MarioGavran/smart_intercom/images/20210518_152732.jpg

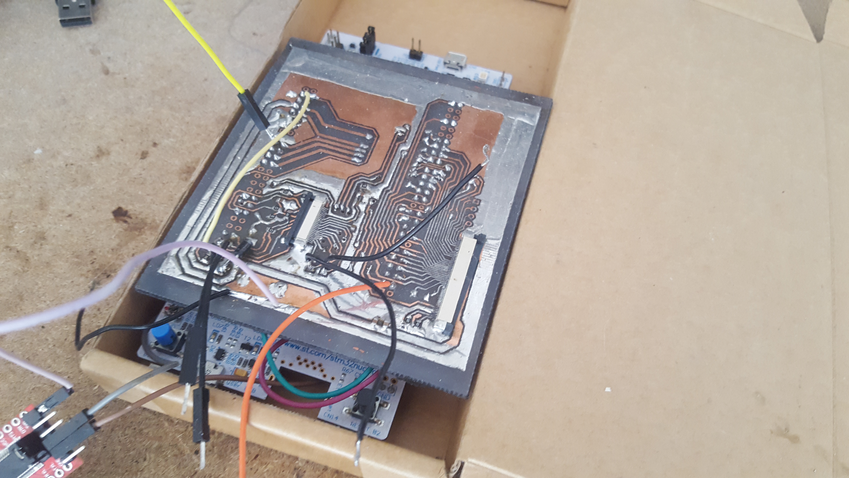
images/20210518_152732.jpg
