MarioGavran/smart_intercom/images/20210518_152829.jpg

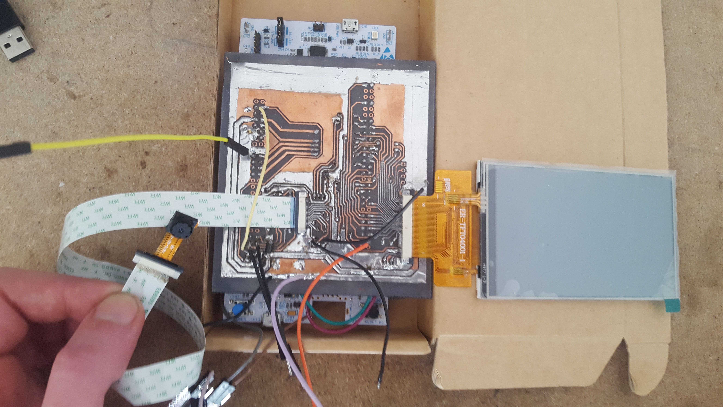
images/20210518_152829.jpg
