MarioGavran/smart_intercom/images/img1.jpg

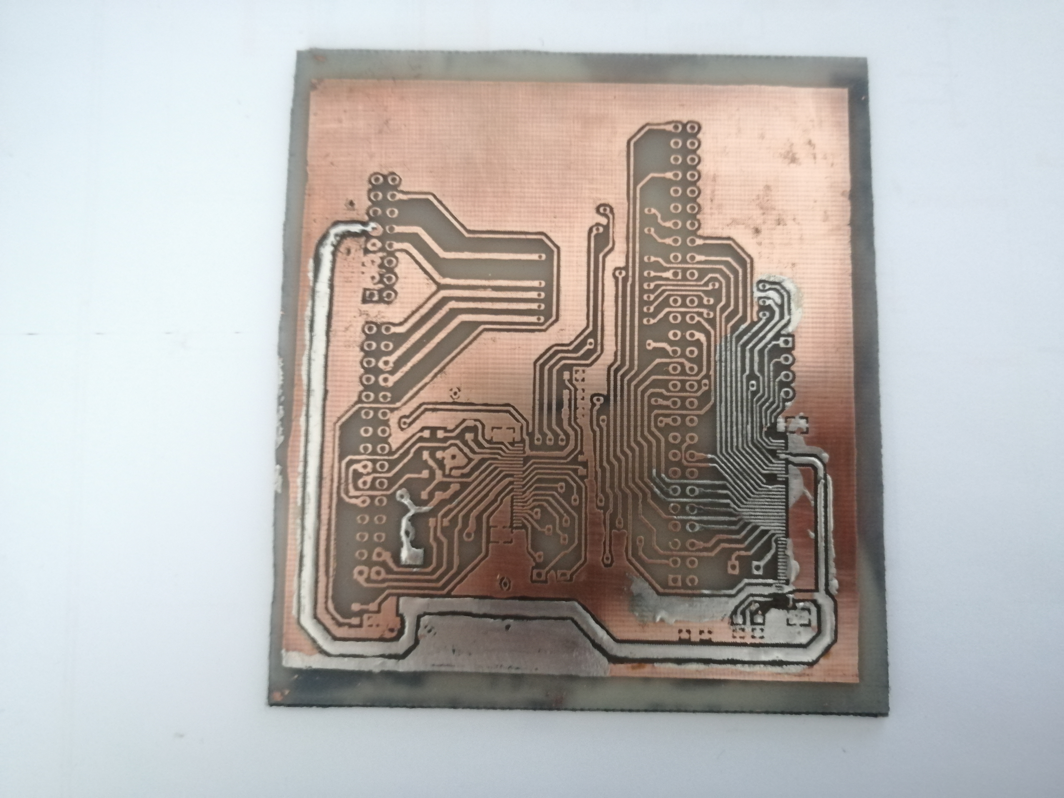
images/img1.jpg
