MarioGavran/smart_intercom/images/img3.jpg

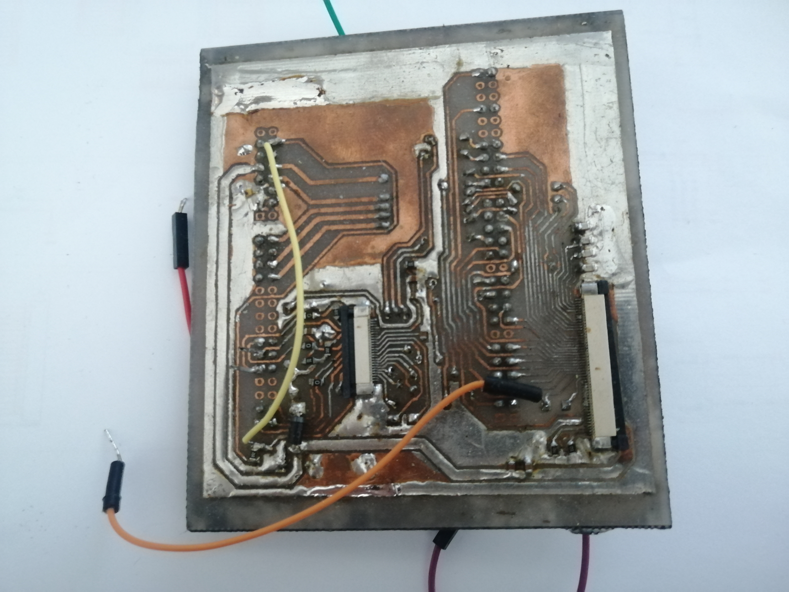
images/img3.jpg
