MarioGavran/smart_intercom/images/img4.jpg

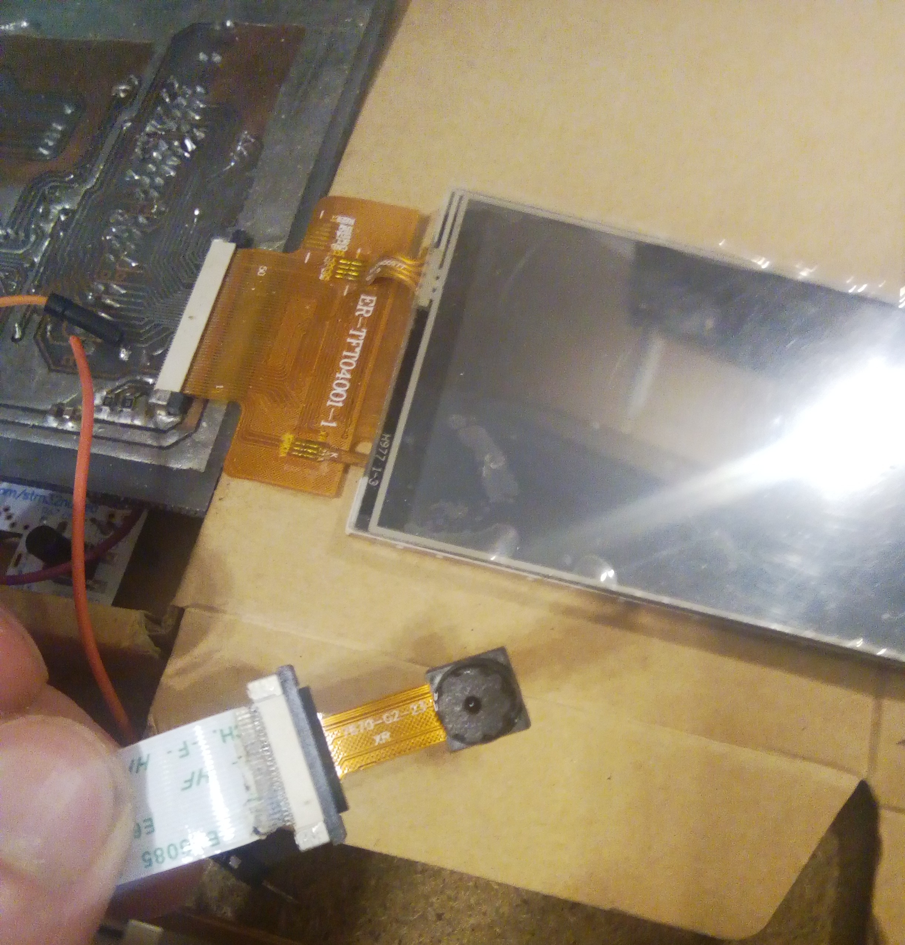
images/img4.jpg
