MarioGavran/smart_intercom/images/img5.jpg

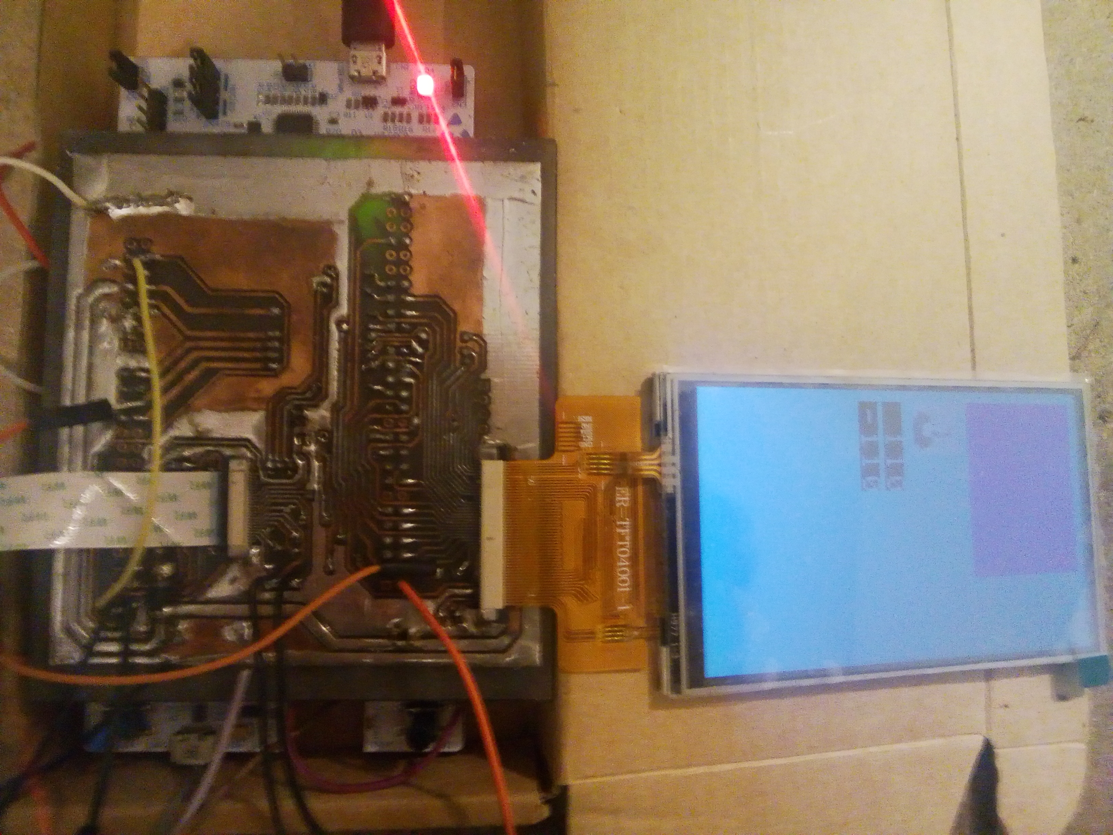
images/img5.jpg
