MarioGavran/smart_intercom/images/img7.jpg

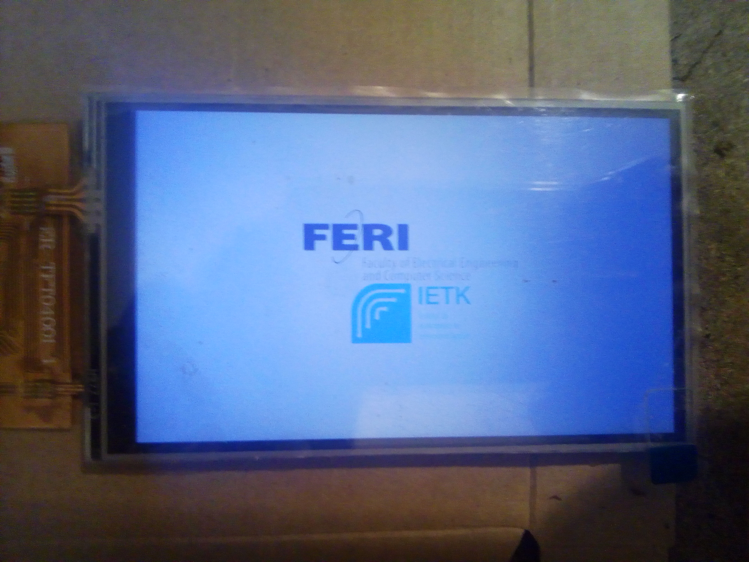
images/img7.jpg
