MarioGavran/smart_intercom/images/img8.jpg

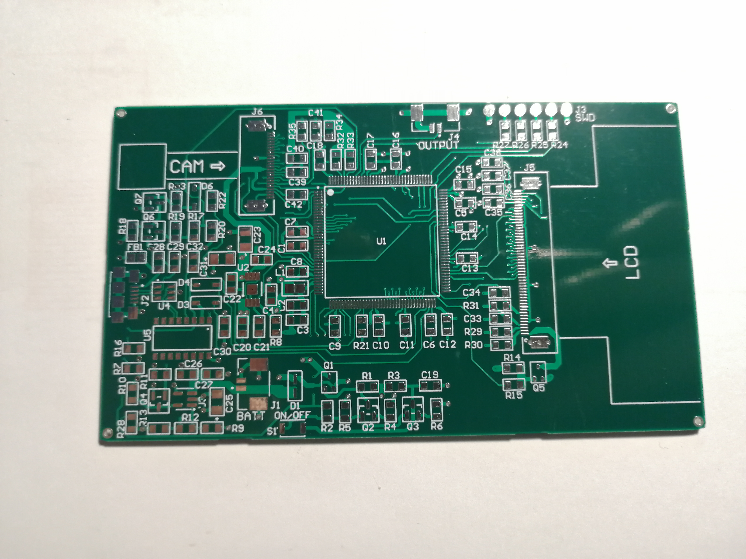
images/img8.jpg
