MarioGavran/smart_intercom/images/img9.jpg

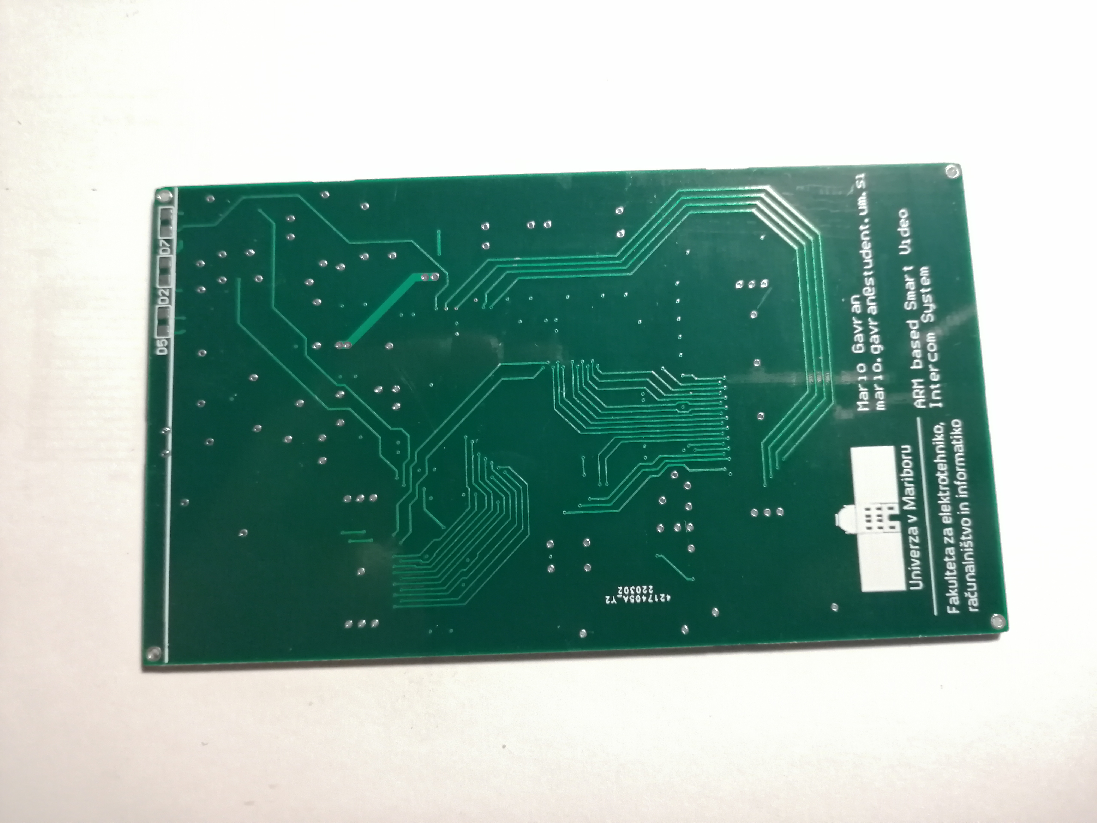
images/img9.jpg
