MarioGavran/smart_intercom/images/img11.jpg

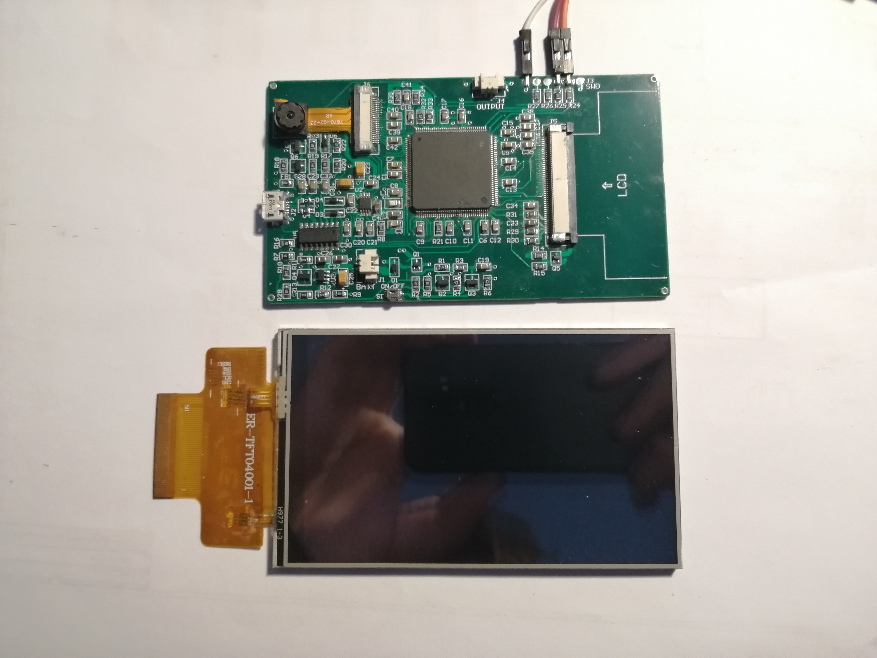
images/img11.jpg
