MarioGavran/smart_intercom/images/img12.jpg

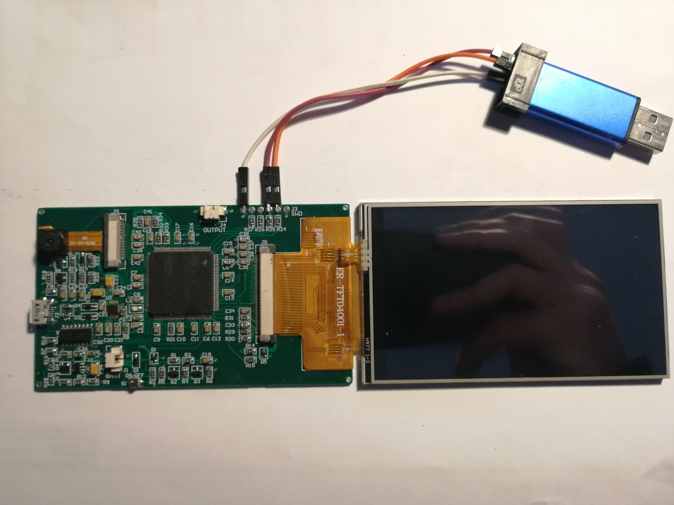
images/img12.jpg
