MarioGavran/smart_intercom/Doc/Schematics.pdf

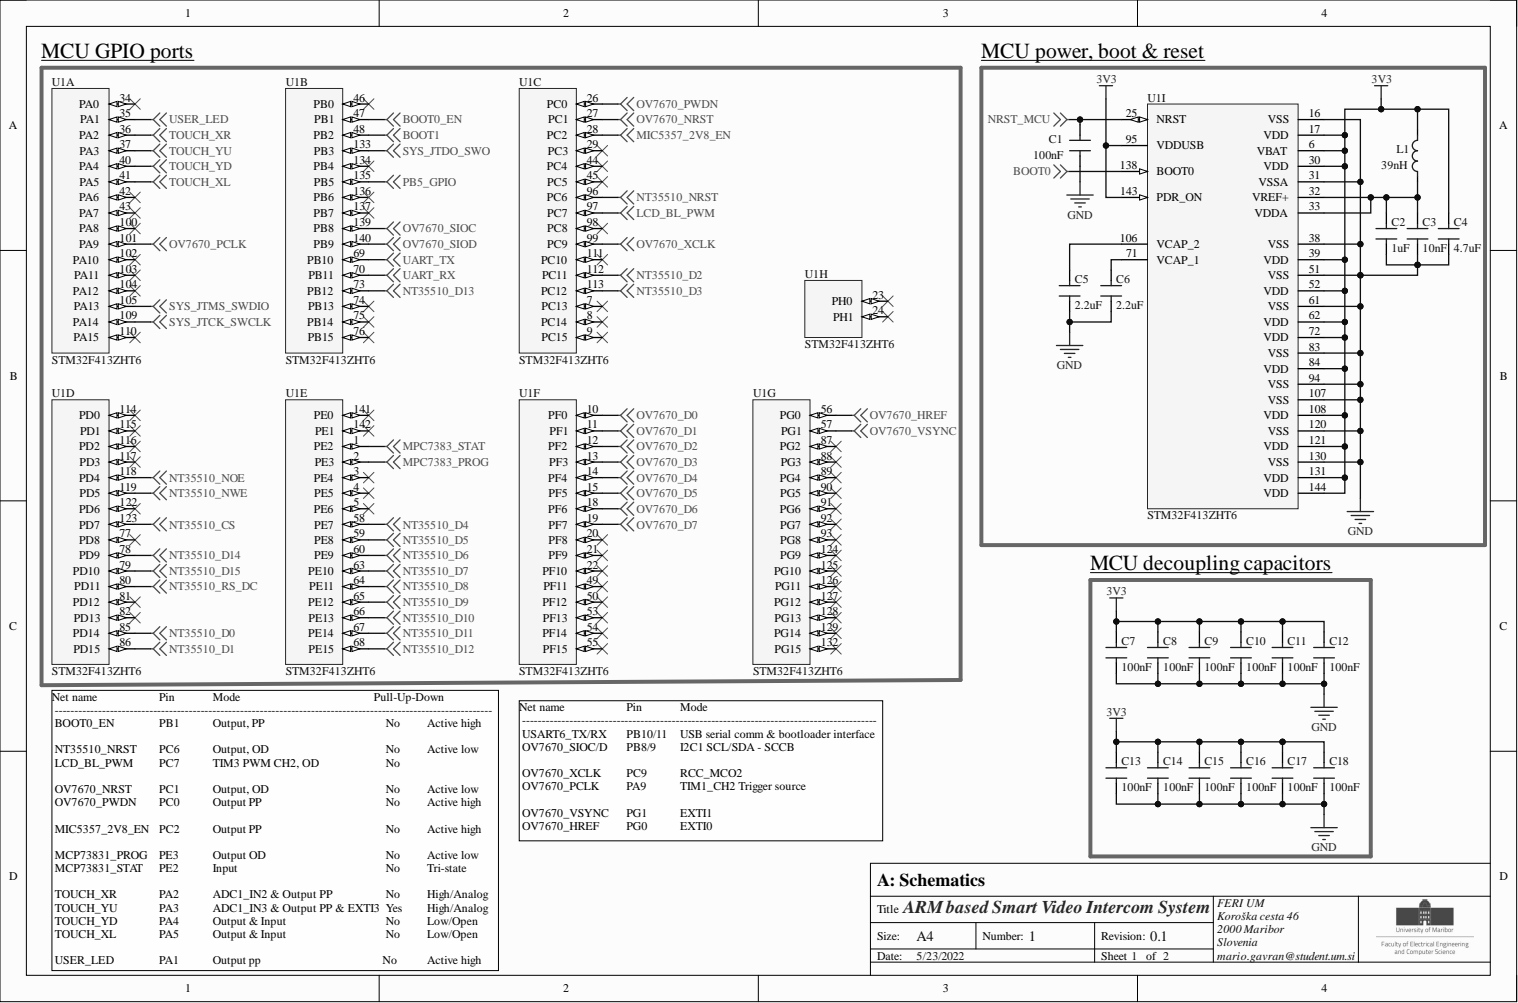
[picture p23: page 1]
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

Size: A | N u mber: | Rev i s i o n : .
Date: / / | | Shee t o f

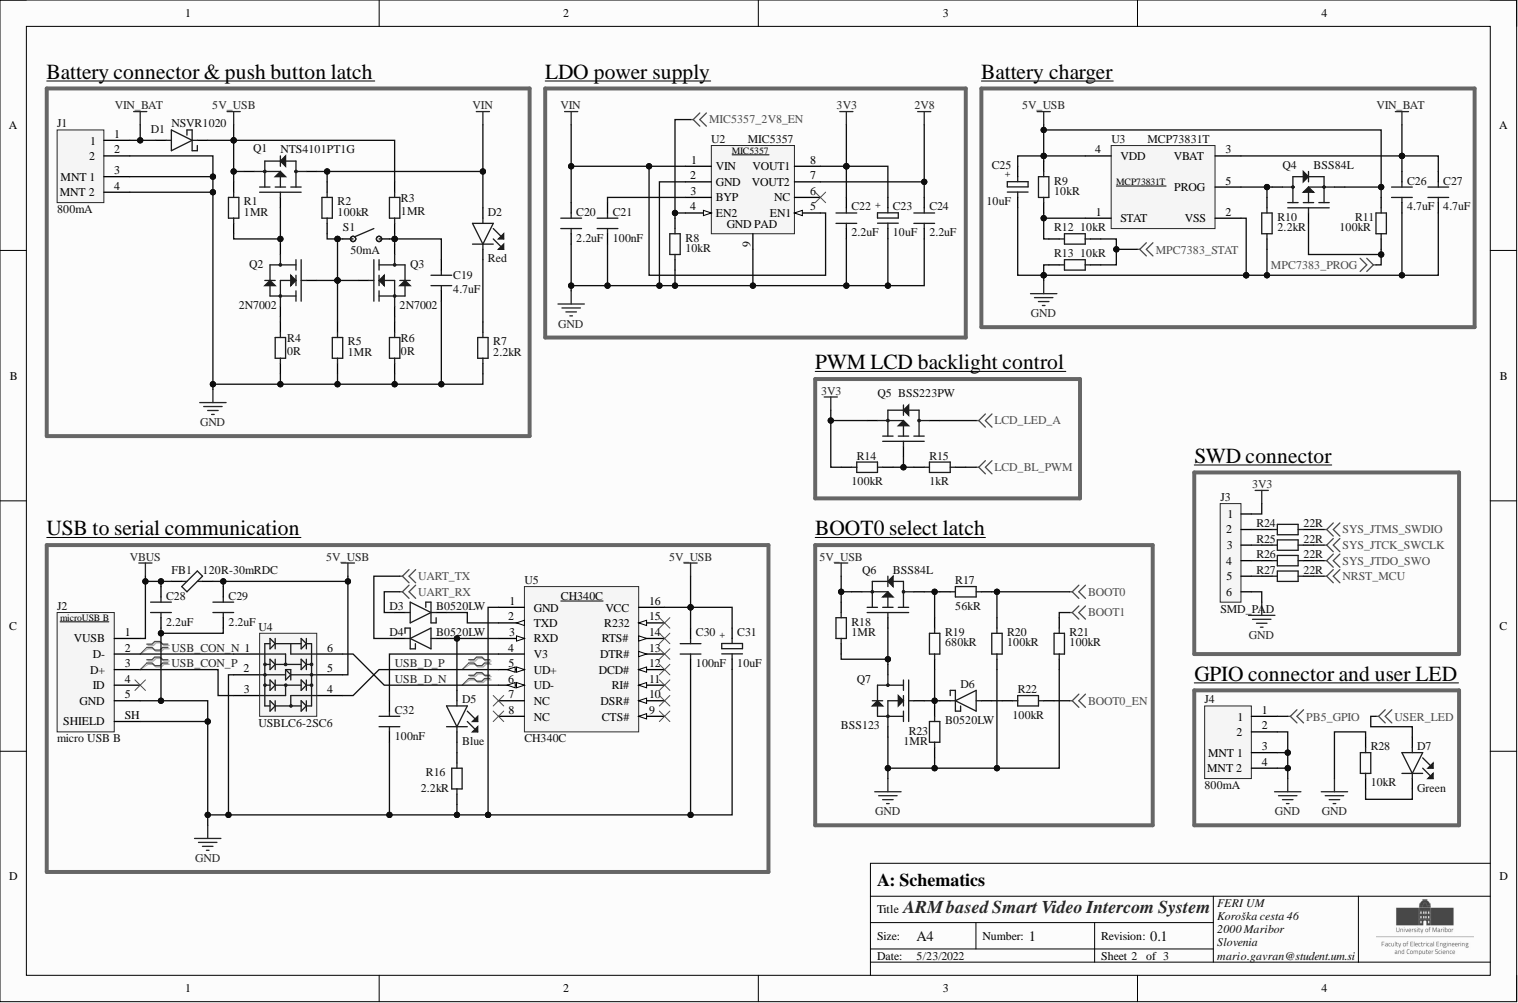
[picture p24: page 2]

EN2 4 EN1 GND 2 GND PAD | 5 NC 6 VOUT2 7 VOUT1 8 MIC5357

BYP 3

STAT 1

PWM LCD backlight control

GND
GPIO connector and user LED

A: Schematics
ARM based Smart Video Intercom System
Title

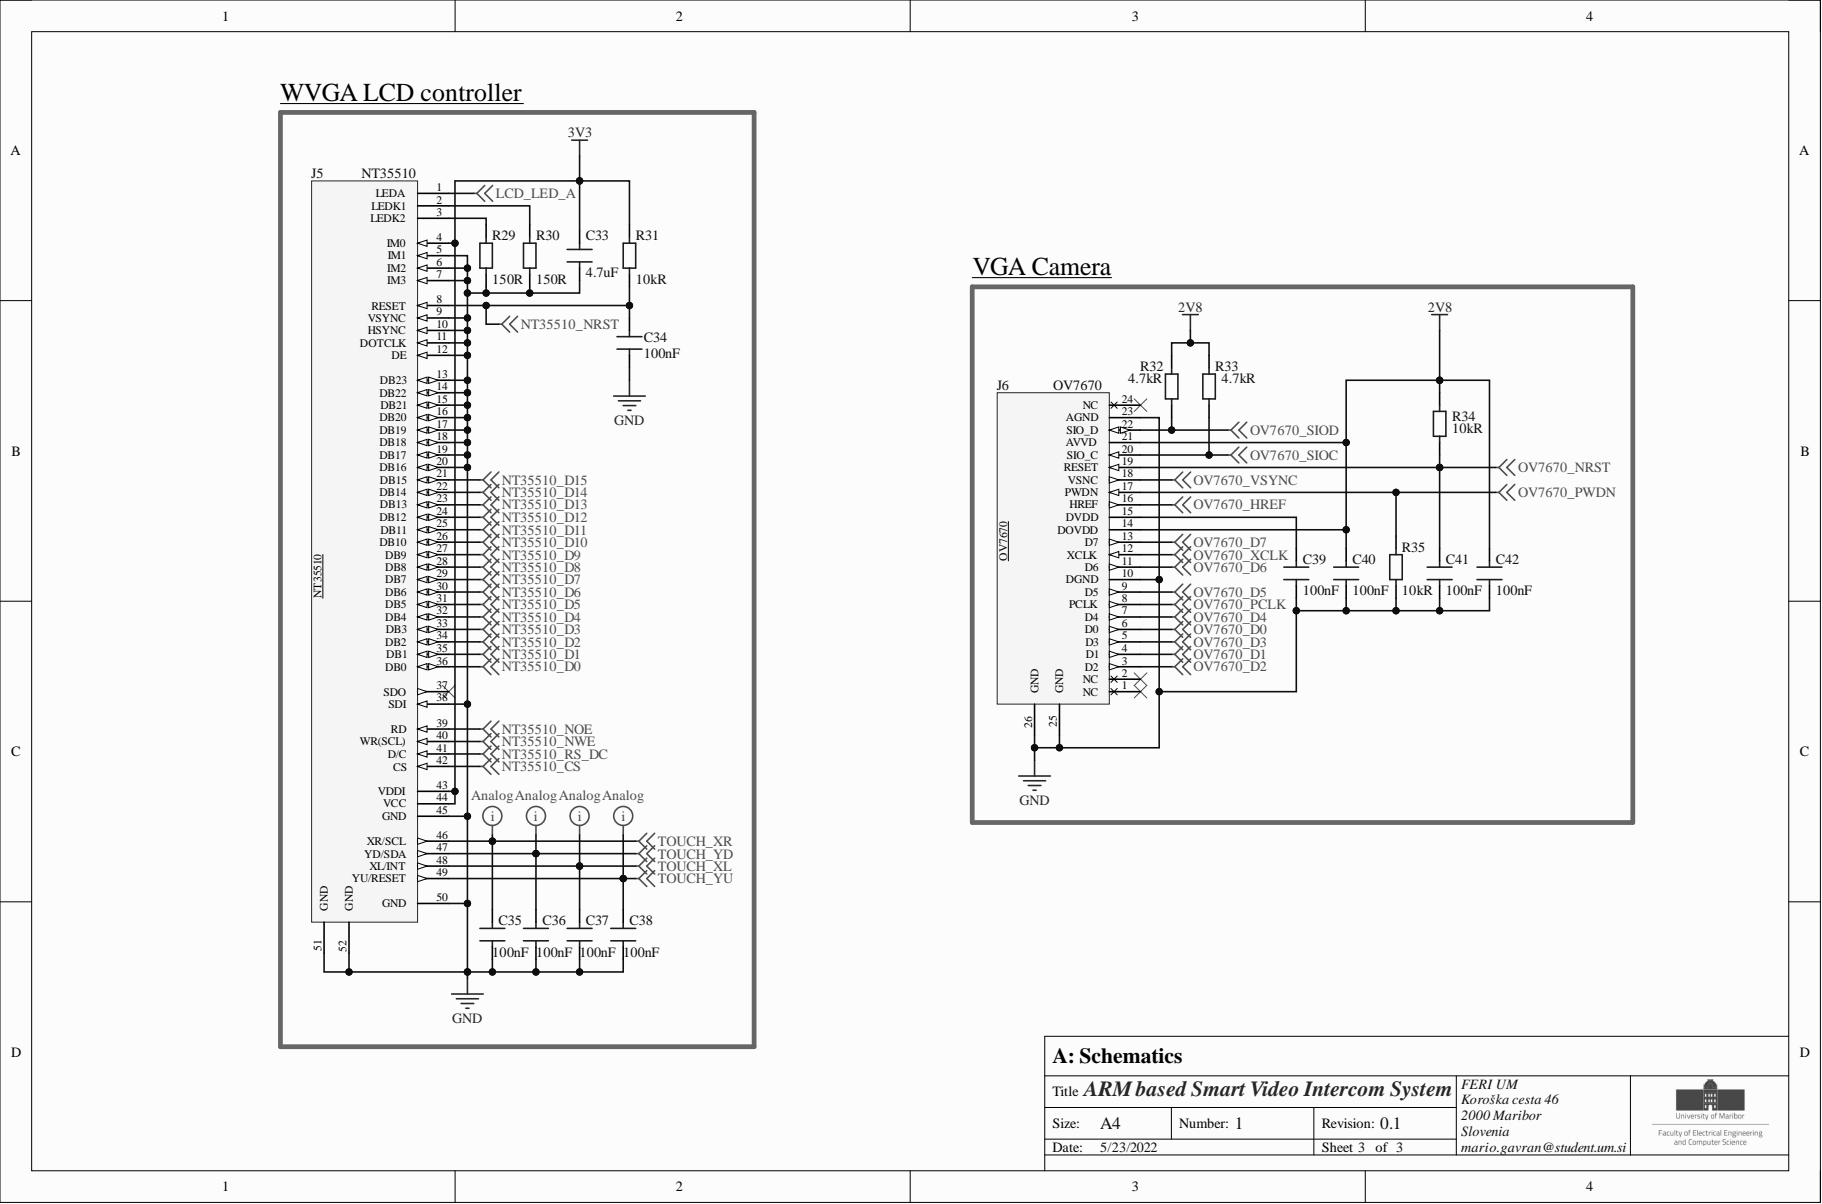
[picture p25: page 3]

O V 7 6 7 0 _ VSY N C
O V 7 6 7 0 _ HRE F

FERI UM Koroška ces
