MarioGavran/smart_intercom/Core/Src/uart_driver.c

/*
 * uart_driver.c
 *
 *  Created on: Mar 18, 2021
 *      Author: Mario
 */
#include "uart_driver.h"


uart_tx_state_t g_uart_tx_state = UART_TX_IDLE;
uart_rx_state_t g_uart_rx_state = UART_RX_IDLE;

uint8_t g_uart_tx_buffer[UART_TX_BUFFER_MAX + 1] = {0};
uint16_t g_uart_tx_nose = 0;
uint16_t g_uart_tx_tail = 0;

uint8_t g_uart_rx_buffer[UART_RX_BUFFER_MAX + 1];
uint8_t g_uart_rx_tmp_buf[50];
uint16_t g_uart_rx_nose = 0;
uint16_t g_uart_rx_tail = 0;
uint16_t g_uart_rx_cnt = 0;



//~=~=~=~=~=~=~=~=~=~=~=~=~=~=~=~=~=~=~=~=~=~=~=~=~=~=~=~=~=~=~=~=~=~=~=~=~=~=~=~=~=~=~=~=~=~=
void uart_init()
{
	__HAL_UART_ENABLE_IT(&huart3, UART_IT_RXNE);
}



//~=~=~=~=~=~=~=~=~=~=~=~=~=~=~=~=~=~=~=~=~=~=~=~=~=~=~=~=~=~=~=~=~=~=~=~=~=~=~=~=~=~=~=~=~=~=
void uart_tx_process()
{
	static uint8_t last_nose = 0;
	uint8_t string_size;

	switch(g_uart_tx_state)
	{
	//****************************
	case UART_TX_IDLE:
		if(g_uart_tx_nose != g_uart_tx_tail)
			g_uart_tx_state = UART_TX_TRANSMIT;
		break;

		//****************************
	case UART_TX_TRANSMIT:
		string_size = strlen(g_uart_tx_buffer + (g_uart_tx_nose)) + 1;

		HAL_UART_Transmit_IT(
				&huart3,
				g_uart_tx_buffer + g_uart_tx_nose,
				string_size);

		last_nose = g_uart_tx_nose;
		g_uart_tx_state = UART_TX_TRANSMITING;
		break;

		//****************************
	case UART_TX_TRANSMITING:
		if((last_nose == g_uart_tx_nose))
			g_uart_tx_state = UART_TX_TRANSMITING;
		else if((last_nose != g_uart_tx_nose) && (g_uart_tx_tail != g_uart_tx_nose))
			g_uart_tx_state = UART_TX_TRANSMIT;
		else if((last_nose != g_uart_tx_nose) && (g_uart_tx_tail == g_uart_tx_nose))
			g_uart_tx_state = UART_TX_IDLE;
		break;
	}
}



//~=~=~=~=~=~=~=~=~=~=~=~=~=~=~=~=~=~=~=~=~=~=~=~=~=~=~=~=~=~=~=~=~=~=~=~=~=~=~=~=~=~=~=~=~=~=
void uart_write(uint8_t* buff)
{
	uint8_t string_size = strlen(buff) + 1;

	if(
			((g_uart_tx_tail - g_uart_tx_nose >= 0) && (string_size < UART_TX_BUFFER_MAX - (g_uart_tx_tail - g_uart_tx_nose))) ||
			((g_uart_tx_tail - g_uart_tx_nose <= 0) && (string_size < g_uart_tx_nose - g_uart_tx_tail)))
	{
		if(((g_uart_tx_tail - g_uart_tx_nose >= 0)) && (string_size > (UART_TX_BUFFER_MAX - g_uart_tx_tail)))
		{
			strncpy(g_uart_tx_buffer + g_uart_tx_tail, buff, UART_TX_BUFFER_MAX - g_uart_tx_tail);
			string_size -= (UART_TX_BUFFER_MAX - g_uart_tx_tail);
			strncpy(g_uart_tx_buffer + 0, buff + (UART_TX_BUFFER_MAX - g_uart_tx_tail), string_size);
			g_uart_tx_tail = 0;
			g_uart_tx_tail = string_size;
		}
		else
		{
			strcpy(g_uart_tx_buffer + g_uart_tx_tail, buff);
			if(g_uart_tx_tail + string_size < UART_TX_BUFFER_MAX)
				g_uart_tx_tail += string_size;
			else
				g_uart_tx_tail = 0;
		}
	}
}



//~=~=~=~=~=~=~=~=~=~=~=~=~=~=~=~=~=~=~=~=~=~=~=~=~=~=~=~=~=~=~=~=~=~=~=~=~=~=~=~=~=~=~=~=~=~=
void HAL_UART_TxCpltCallback(UART_HandleTypeDef *huart)
{
	g_uart_tx_nose += strlen(g_uart_tx_buffer + g_uart_tx_nose) + 1;

	if(g_uart_tx_nose >= UART_TX_BUFFER_MAX)
		g_uart_tx_nose = 0;

}



//~=~=~=~=~=~=~=~=~=~=~=~=~=~=~=~=~=~=~=~=~=~=~=~=~=~=~=~=~=~=~=~=~=~=~=~=~=~=~=~=~=~=~=~=~=~=
void uart_rx_process()
{
	uint8_t string_size = strlen(g_uart_rx_buffer + g_uart_rx_nose + 1) + 1;

	switch(g_uart_rx_state)
	{
	case UART_RX_IDLE:
		if(g_uart_rx_cnt)
			g_uart_rx_state = UART_RX_RECEIVE;
		break;

	case UART_RX_RECEIVE:
		if(g_uart_rx_nose < g_uart_rx_tail &&
				(g_uart_rx_buffer[g_uart_rx_nose + string_size - 2] == '\r') &&
				(g_uart_rx_buffer[g_uart_rx_nose + string_size - 1] == '\n'))
		{
			serial_protocol(g_uart_rx_buffer + g_uart_rx_nose + 1);
		}
		else if((g_uart_rx_nose > g_uart_rx_tail) &&
							(g_uart_rx_buffer[strlen(g_uart_rx_buffer) - 1] == '\n'))
		{
			strncpy(g_uart_rx_tmp_buf, g_uart_rx_buffer + g_uart_rx_nose + 1, string_size);
			string_size = strlen(g_uart_rx_buffer + 1) + 1;
			strncpy(g_uart_rx_tmp_buf + strlen(g_uart_rx_tmp_buf), g_uart_rx_buffer , string_size);
			serial_protocol(g_uart_rx_tmp_buf);
		}

		g_uart_rx_cnt--;

		if(g_uart_rx_nose + string_size < UART_RX_BUFFER_MAX)
			g_uart_rx_nose += string_size;
		else
			g_uart_rx_nose = string_size;

		if(!g_uart_rx_cnt)
			g_uart_rx_state = UART_RX_IDLE;
		break;


	}
}



//~=~=~=~=~=~=~=~=~=~=~=~=~=~=~=~=~=~=~=~=~=~=~=~=~=~=~=~=~=~=~=~=~=~=~=~=~=~=~=~=~=~=~=~=~=~=
void uart_rx_callback()
{
	g_uart_rx_tail++;

	if((g_uart_rx_tail < (UART_RX_BUFFER_MAX - 1)) && ((g_uart_rx_nose < g_uart_rx_tail) || (g_uart_rx_nose - g_uart_rx_tail > 2/*1*/)))
	{
		g_uart_rx_buffer[g_uart_rx_tail] = (0x00FFU & USART3->DR);//253
		if((g_uart_rx_buffer[g_uart_rx_tail] == '\r') /*&& ((g_uart_rx_nose < g_uart_rx_tail) || (g_uart_rx_nose - g_uart_rx_tail > 2))*/)
		{
			g_uart_rx_buffer[++g_uart_rx_tail] = '\n';//254
			g_uart_rx_cnt++;
			g_uart_rx_buffer[++g_uart_rx_tail] = '\0';//255
			if((g_uart_rx_tail == UART_RX_BUFFER_MAX) && (g_uart_rx_nose > 0))
			{
				g_uart_rx_tail = 0;
			}
		}
	}
	else if((g_uart_rx_tail == (UART_RX_BUFFER_MAX - 1)) && (g_uart_rx_nose > 1)/*(g_uart_rx_nose < g_uart_rx_tail)*/)
	{
		g_uart_rx_buffer[g_uart_rx_tail] = (0x00FFU & USART3->DR);//254
		g_uart_rx_buffer[++g_uart_rx_tail] = '\0';//255
		if(g_uart_rx_buffer[g_uart_rx_tail - 1] == '\r')
		{
			g_uart_rx_cnt++;
			if(g_uart_rx_nose > 1)
			{
				g_uart_rx_tail = 0;
				g_uart_rx_buffer[g_uart_rx_tail] = '\n';//0
				g_uart_rx_buffer[++g_uart_rx_tail] = '\0';//1
			}
			else
			{
				//error - full
			}
		}
	}
	else if((g_uart_rx_tail == UART_RX_BUFFER_MAX) && (g_uart_rx_nose > 1))
	{
		g_uart_rx_buffer[g_uart_rx_tail] = '\0';
		g_uart_rx_tail = 1;
		g_uart_rx_buffer[g_uart_rx_tail] = (0x00FFU & USART3->DR);	//todo:zamjeni USART->DR za neki define

	}

}


#include <stdlib.h>
//~=~=~=~=~=~=~=~=~=~=~=~=~=~=~=~=~=~=~=~=~=~=~=~=~=~=~=~=~=~=~=~=~=~=~=~=~=~=~=~=~=~=~=~=~=~=
void serial_protocol(uint8_t* buff)
{
	char *token;
	char temp_buff[5] = {0};
	unsigned short address, value = 0xFF;
	unsigned short value1, value2, value3, value4 = 0xFF;

	token = strtok(buff, ",");

	if (strncmp(buff, "OVW", 3) == 0)
	{
		token = strtok(NULL, ",");
		strncpy(temp_buff, token, 2);
		address = strtoll(temp_buff, NULL, 16);

		token = strtok(NULL, ",");
		strncpy(temp_buff, token, 2);
		value = strtoll(temp_buff, NULL, 16);

		ov7670_write_register(address, value);
		sprintf(temp_buff, "%02X\0", address);
		LCD_PrintStr(20, 380, 0, 0x841FU, temp_buff, 5);
		sprintf(temp_buff, "%02X\0", ov7670_read_register(address));
		LCD_PrintStr(20, 420, 0, 0x841FU, temp_buff, 5);
	}
	else if (strncmp(buff, "OVR", 3) == 0)
	{
		token = strtok(NULL, ",");
		strncpy(temp_buff, token, 2);
		address = strtoll(temp_buff, NULL, 16);

		value = ov7670_read_register(address);

		sprintf(temp_buff, "%02X\0", address);
		LCD_PrintStr(20, 380, 0, 0x841FU, temp_buff, 5);
		sprintf(temp_buff, "%02X\0", value);
		LCD_PrintStr(20, 420, 0, 0x841FU, temp_buff, 5);
	}
	else if (strncmp(buff, "OVHV", 4) == 0)
	{
		token = strtok(NULL, ",");
		strncpy(temp_buff, token, 3);
		value1 = strtoll(temp_buff, NULL, 10);

		token = strtok(NULL, ",");
		strncpy(temp_buff, token, 3);
		value2 = strtoll(temp_buff, NULL, 10);

		token = strtok(NULL, ",");
		strncpy(temp_buff, token, 3);
		value3 = strtoll(temp_buff, NULL, 10);

		token = strtok(NULL, ",");
		strncpy(temp_buff, token, 3);
		value4 = strtoll(temp_buff, NULL, 10);

		ov7670_frame_control(value1, value2, value3, value4);
	}
	else if (strncmp(buff, "ROVHV", 5) == 0)
	{
		value = 0;
		value = ov7670_read_register(OV7670_HSTART) << 3;
		value |= ov7670_read_register(OV7670_HREF) & 0b00000111;
		sprintf(temp_buff, "%03d\0", value);
		LCD_PrintStr(100, 300, 0, 0x841FU, temp_buff, 5);

		value = 0;
		value = ov7670_read_register(OV7670_HSTOP) << 3;
		value |= (ov7670_read_register(OV7670_HREF) & 0b00111000) >> 3;
		sprintf(temp_buff, "%03d\0", value);
		LCD_PrintStr(100, 340, 0, 0x841FU, temp_buff, 5);

		value = 0;
		value = ov7670_read_register(OV7670_VSTART) << 2;
		value |= ov7670_read_register(OV7670_VREF) & 0b00000011;
		sprintf(temp_buff, "%03d\0", value);
		LCD_PrintStr(100, 380, 0, 0x841FU, temp_buff, 5);

		value = 0;
		value = ov7670_read_register(OV7670_VSTOP) << 2;
		value |= (ov7670_read_register(OV7670_VREF) & 0b00001100) >> 2;
		sprintf(temp_buff, "%03d\0", value);
		LCD_PrintStr(100, 420, 0, 0x841FU, temp_buff, 5);
	}
	else if (strncmp(buff, "SWI", 3) == 0)
	{
		token = strtok(NULL, ",");
		if (strncmp(token, "touch", 5) == 00)
			HAL_EXTI_GenerateSWI(&hexti_touch_YU);
	}
	else if(strncmp(buff, "OVSETF", 6) == 0)
	{
		token = strtok(NULL, ",");
		if(strncmp(token, "QVGA", 4) == 0)
		{
			g_ov7670_info.frame_params = ov7670_frame_params[FFMT_QVGA];
			ov7670_set_mode(300);
		}
		else if(strncmp(token, "QQVGA", 5) == 0)
		{
			g_ov7670_info.frame_params = ov7670_frame_params[FFMT_QQVGA];
			ov7670_set_mode(300);
		}
		else if(strncmp(token, "QQQVGA", 6) == 0)
		{
			g_ov7670_info.frame_params = ov7670_frame_params[FFMT_QQQVGA];
			ov7670_set_mode(300);
		}
		else if(strncmp(token, "CIF", 3) == 0)
		{
			g_ov7670_info.frame_params = ov7670_frame_params[FFMT_CIF];
			ov7670_set_mode(300);
		}
		else if(strncmp(token, "QCIF", 4) == 0)
		{
			g_ov7670_info.frame_params = ov7670_frame_params[FFMT_QCIF];
			ov7670_set_mode(300);
		}
	}
	else if(strncmp(buff, "OVSETC", 6) == 0)
	{
		token = strtok(NULL, ",");
		if(strncmp(token, "RGB5", 4) == 0)
			g_ov7670_info.color_fmt = CFMT_RGB555;
		else if(strncmp(token, "RGB6", 4) == 0)
			g_ov7670_info.color_fmt = CFMT_RGB565;
		else if(strncmp(token, "RGB4", 4) == 0)
			g_ov7670_info.color_fmt = CFMT_RGB444;
		else if(strncmp(token, "GRB", 3) == 0)
			g_ov7670_info.color_fmt = CFMT_GRB422;
		else if(strncmp(token, "YUV", 3) == 0)
			g_ov7670_info.color_fmt = CFMT_YUYV422;
		else if(strncmp(token, "RBAY", 4) == 0)
			g_ov7670_info.color_fmt = CFMT_RAW_BAYER;
		else if(strncmp(token, "PBAY", 4) == 0)
			g_ov7670_info.color_fmt = CFMT_PRO_BAYER;

		ov7670_set_mode(300);
	}
	else if(strncmp(buff, "OVSCL", 5) == 0)
	{
		token = strtok(NULL, ",");
		strncpy(temp_buff, token, 3);
		value1 = strtoll(temp_buff, NULL, 10);

		token = strtok(NULL, ",");
		strncpy(temp_buff, token, 3);
		value2 = strtoll(temp_buff, NULL, 10);

		ov7670_scaling_control(value1, value2);
	}
}
