MarioGavran/smart_intercom/Core/Src/feri_logo_image.c

#include <feri_logo_image.h>



const unsigned char g_feri_logo_image[FERI_LOGO_IMG_SIZE] = {
		0xff,0xff,0xff,0xff,0xff,0xff,0xff,0xff,0xff,0xff,0xff,0xff,0xff,0xff,0xff,0xff,0xff,0xff,0xff,0xff,0xff,0xff,0xff,0xff,0xff,0xff,0xff,0xff,0xff,0xff,0xff,0xff,0xff,0xff,0xff,0xff,0xff,0xff,0xff,0xff,0xff,0xff,0xff,0xff,0xff,0xff,0xff,0xff,0xff,0xff,0xff,0xff,0xff,0xff,0xff,0xff,0xff,0xff,0xff,0xf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
		,0xff,0xff,0xff,0xff,0xff,0xff,0xff,0xff,0xff,0xff,0xff,0xff,0xff,0xff,0xff,0xff,0xff,0xff,0xff,0xff,0xff,0xff,0xff,0xff,0xff,0xff,0xff,0xff,0xff,0xff,0xff,0xff,0xff,0xff,0xff,0xff,0xff,0xff,0xff,0xff,0xff,0xff,0xff,0xff,0xff,0xff,0xff,0xff,0xff,0xff,0xff,0xff,0xff,0xff,0xff,0xff,0xff,0xff,0xff,0x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
		,0xff,0xff,0xff,0xff,0xff,0xff,0xff,0xff,0xff,0xff,0xff,0xff,0xff,0xff,0xff,0xff,0xff,0xff,0xff,0xff,0xff,0xff,0xff,0xff,0xff,0xff,0xff,0xff,0xff,0xff,0xff,0xff,0xff,0xff,0xff,0xff,0xff,0xff,0xff,0xff,0xff,0xff,0xff,0xff,0xff,0xff,0xff,0xff,0xff,0xff,0xff,0xff,0xff,0xff,0xff,0xff,0xff,0xff,0xff,0x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
		,0xff,0xff,0xff,0xff,0xff,0xff,0xff,0xff,0xff,0xff,0xff,0xff,0xff,0xff,0xff,0xff,0xff,0xff,0xff,0xff,0xff,0xff,0xff,0xff,0xff,0xff,0xff,0xff,0xff,0xff,0xff,0xff,0xff,0xff,0xff,0xff,0xff,0xff,0xff,0xff,0xff,0xff,0xff,0xff,0xff,0xff,0xff,0xff,0xff,0xff,0xff,0xff,0xff,0xff,0xff,0xff,0xff,0xff,0xff,0x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
		,0xff,0xff,0xff,0xff,0xff,0xff,0xff,0xff,0xff,0xff,0xff,0xff,0xff,0xff,0xff,0xff,0xff,0xff,0xff,0xff,0xff,0xff,0xff,0xff,0xff,0xff,0xff,0xff,0xff,0xff,0xff,0xff,0xff,0xff,0xff,0xff,0xff,0xff,0xff,0xff,0xff,0xff,0xff,0xff,0xff,0xff,0xff,0xff,0xff,0xff,0xff,0xff,0xff,0xff,0xff,0xff,0xff,0xff,0xff,0x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
		,0xff,0xff,0xff,0xff,0xff,0xff,0xff,0xff,0xff,0xff,0xff,0xff,0xff,0xff,0xff,0xff,0xff,0xff,0xff,0xff,0xff,0xff,0xff,0xff,0xff,0xff,0xff,0xff,0xff,0xff,0xff,0xff,0xff,0xff,0xff,0xff,0xff,0xff,0xff,0xff,0xff,0xff,0xff,0xff,0xff,0xff,0xff,0xff,0xff,0xff,0xff,0xff,0xff,0xff,0xff,0xff,0xff,0xff,0xff,0x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
		,0xff,0xff,0xff,0xff,0xff,0xff,0xff,0xff,0xff,0xff,0xff,0xff,0xff,0xff,0xff,0xff,0xff,0xff,0xff,0xff,0xff,0xff,0xff,0xff,0xff,0xff,0xff,0xff,0xff,0xff,0xff,0xff,0xff,0xff,0xff,0xff,0xff,0xff,0xff,0xff,0xff,0xff,0xff,0xff,0xff,0xff,0xff,0xff,0xff,0xff,0xff,0xff,0xff,0xff,0xff,0xff,0xff,0xff,0xff,0x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
		,0xff,0xff,0xff,0xff,0xff,0xff,0xff,0xff,0xff,0xff,0xff,0xff,0xff,0xff,0xff,0xff,0xff,0xff,0xff,0xff,0xff,0xff,0xff,0xff,0xff,0xff,0xff,0xff,0xff,0xff,0xff,0xff,0xff,0xff,0xff,0xff,0xff,0xff,0xff,0xff,0xff,0xff,0xff,0xff,0xff,0xff,0xff,0xff,0xff,0xff,0xff,0xff,0xff,0xff,0xff,0xff,0xff,0xff,0xff,0x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
		,0xff,0xff,0xff,0xff,0xff,0xff,0xff,0xff,0xff,0xff,0xff,0xff,0xff,0xff,0xff,0xff,0xff,0xff,0xff,0xff,0xff,0xff,0xff,0xff,0xff,0xff,0xff,0xff,0xff,0xff,0xff,0xff,0xff,0xff,0xff,0xff,0xff,0xff,0xff,0xff,0xff,0xff,0xff,0xff,0xff,0xff,0xff,0xff,0xff,0xff,0xff,0xff,0xff,0xff,0xff,0xff,0xff,0xff,0xff,0x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
		,0xff,0xff,0xff,0xff,0xff,0xff,0xff,0xff,0xff,0xff,0xff,0xff,0xff,0xff,0xff,0xff,0xff,0xff,0xff,0xff,0xff,0xff,0xff,0xff,0xff,0xff,0xff,0xff,0xff,0xff,0xff,0xff,0xff,0xff,0xff,0xff,0xff,0xff,0xff,0xff,0xff,0xff,0xff,0xff,0xff,0xff,0xff,0xff,0xff,0xff,0xff,0xff,0xff,0xff,0xff,0xff,0xff,0xff,0xff,0x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
		,0xff,0xff,0xff,0xff,0xff,0xff,0xff,0xff,0xff,0xff,0xff,0xff,0xff,0xff,0xff,0xff,0xff,0xff,0xff,0xff,0xff,0xff,0xff,0xff,0xff,0xff,0xff,0xff,0xff,0xff,0xff,0xff,0xff,0xff,0xff,0xff,0xff,0xff,0xff,0xff,0xff,0xff,0xff,0xff,0xff,0xff,0xff,0xff,0xff,0xff,0xff,0xff,0xff,0xff,0xff,0xff,0xff,0xff,0xff,0x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
		,0xff,0xff,0xff,0xff,0xff,0xff,0xff,0xff,0xff,0xff,0xff,0xff,0xff,0xff,0xff,0xff,0xff,0xff,0xff,0xff,0xff,0xff,0xff,0xff,0xff,0xff,0xff,0xff,0xff,0xff,0xff,0xff,0xff,0xff,0xff,0xff,0xff,0xff,0xff,0xff,0xff,0xff,0xff,0xff,0xff,0xff,0xff,0xff,0xff,0xff,0xff,0xff,0xff,0xff,0xff,0xff,0xff,0xff,0xff,0x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
		,0xff,0xff,0xff,0xff,0xff,0xff,0xff,0xff,0xff,0xff,0xff,0xff,0xff,0xff,0xff,0xff,0xff,0xff,0xff,0xff,0xff,0xff,0xff,0xff,0xff,0xff,0xff,0xff,0xff,0xff,0xff,0xff,0xff,0xff,0xff,0xff,0xff,0xff,0xff,0xff,0xff,0xff,0xff,0xff,0xff,0xff,0xff,0xff,0xff,0xff,0xff,0xff,0xff,0xff,0xff,0xff,0xff,0xff,0xff,0x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
		,0xff,0xff,0xff,0xff,0xff,0xff,0xff,0xff,0xff,0xff,0xff,0xff,0xff,0xff,0xff,0xff,0xff,0xff,0xff,0xff,0xff,0xff,0xff,0xff,0xff,0xff,0xff,0xff,0xff,0xff,0xff,0xff,0xff,0xff,0xff,0xff,0xff,0xff,0xff,0xff,0xff,0xff,0xff,0xff,0xff,0xff,0xff,0xff,0xff,0xff,0xff,0xff,0xff,0xff,0xff,0xff,0xff,0xff,0xff,0x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
		,0xff,0xff,0xff,0xff,0xff,0xff,0xff,0xff,0xff,0xff,0xff,0xff,0xff,0xff,0xff,0xff,0xff,0xff,0xff,0xff,0xff,0xff,0xff,0xff,0xff,0xff,0xff,0xff,0xff,0xff,0xff,0xff,0xff,0xff,0xff,0xff,0xff,0xff,0xff,0xff,0xff,0xff,0xff,0xff,0xff,0xff,0xff,0xff,0xff,0xff,0xff,0xff,0xff,0xff,0xff,0xff,0xff,0xff,0xff,0x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
		,0xff,0xff,0xff,0xff,0xff,0xff,0xff,0xff,0xff,0xff,0xff,0xff,0xff,0xff,0xff,0xff,0xff,0xff,0xff,0xff,0xff,0xff,0xff,0xff,0xff,0xff,0xff,0xff,0xff,0xff,0xff,0xff,0xff,0xff,0xff,0xff,0xff,0xff,0xff,0xff,0xff,0xff,0xff,0xff,0xff,0xff,0xff,0xff,0xff,0xff,0xff,0xff,0xff,0xff,0xff,0xff,0xff,0xff,0xff,0x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
		,0xff,0xff,0xff,0xff,0xff,0xff,0xff,0xff,0xff,0xff,0xff,0xff,0xff,0xff,0xff,0xff,0xff,0xff,0xff,0xff,0xff,0xff,0xff,0xff,0xff,0xff,0xff,0xff,0xff,0xff,0xff,0xff,0xff,0xff,0xff,0xff,0xff,0xff,0xff,0xff,0xff,0xff,0xff,0xff,0xff,0xff,0xff,0xff,0xff,0xff,0xff,0xff,0xff,0xff,0xff,0xff,0xff,0xff,0xff,0x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
		,0xff,0xff,0xff,0xff,0xff,0xff,0xff,0xff,0xff,0xff,0xff,0xff,0xff,0xff,0xff,0xff,0xff,0xff,0xff,0xff,0xff,0xff,0xff,0xff,0xff,0xff,0xff,0xff,0xff,0xff,0xff,0xff,0xff,0xff,0xff,0xff,0xff,0xff,0xff,0xff,0xff,0xff,0xff,0xff,0xff,0xff,0xff,0xff,0xff,0xff,0xff,0xff,0xff,0xff,0xff,0xff,0xff,0xff,0xff,0x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
		,0xff,0xff,0xff,0xff,0xff,0xff,0xff,0xff,0xff,0xff,0xff,0xff,0xff,0xff,0xff,0xff,0xff,0xff,0xff,0xff,0xff,0xff,0xff,0xff,0xff,0xff,0xff,0xff,0xff,0xff,0xff,0xff,0xff,0xff,0xff,0xff,0xff,0xff,0xff,0xff,0xff,0xff,0xff,0xff,0xff,0xff,0xff,0xff,0xff,0xff,0xff,0xff,0xff,0xff,0xff,0xff,0xff,0xff,0xff,0x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
		,0xff,0xff,0xff,0xff,0xff,0xff,0xff,0xff,0xff,0xff,0xff,0xff,0xff,0xff,0xff,0xff,0xff,0xff,0xff,0xff,0xff,0xff,0xff,0xff,0xff,0xff,0xff,0xff,0xff,0xff,0xff,0xff,0xff,0xff,0xff,0xff,0xff,0xff,0xff,0xff,0xff,0xff,0xff,0xff,0xff,0xff,0xff,0xff,0xff,0xff,0xff,0xff,0xff,0xff,0xff,0xff,0xff,0xff,0xff,0x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
		,0xff,0xff,0xff,0xff,0xff,0xff,0xff,0xff,0xff,0xff,0xff,0xff,0xff,0xff,0xff,0xff,0xff,0xff,0xff,0xff,0xff,0xff,0xff,0xff,0xff,0xff,0xff,0xff,0xff,0xff,0xff,0xff,0xff,0xff,0xff,0xff,0xff,0xff,0xff,0xff,0xff,0xff,0xff,0xff,0xff,0xff,0xff,0xff,0xff,0xff,0xff,0xff,0xff,0xff,0xff,0xff,0xff,0xff,0xff,0x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
		,0xff,0xff,0xff,0xff,0xff,0xff,0xff,0xff,0xff,0xff,0xff,0xff,0xff,0xff,0xff,0xff,0xff,0xff,0xff,0xff,0xff,0xff,0xff,0xff,0xff,0xff,0xff,0xff,0xff,0xff,0xff,0xff,0xff,0xff,0xff,0xff,0xff,0xff,0xff,0xff,0xff,0xff,0xff,0xff,0xff,0xff,0xff,0xff,0xff,0xff,0xff,0xff,0xff,0xff,0xff,0xff,0xff,0xff,0xff,0x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
		,0x9d,0x56,0x8d,0x15,0x95,0x16,0x95,0x16,0x95,0x16,0x95,0x16,0x95,0x16,0x95,0x16,0x95,0x16,0x95,0x16,0x95,0x16,0x95,0x16,0x95,0x16,0x95,0x16,0x95,0x16,0x95,0x16,0x95,0x16,0x95,0x16,0x95,0x16,0x95,0x16,0x95,0x16,0x95,0x16,0x95,0x16,0x95,0x16,0x95,0x16,0x95,0x16,0x95,0x16,0x95,0x16,0x95,0x16,0x95,0x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
		,0x3a,0xce,0x2a,0x4d,0x2a,0x4d,0x2a,0x4d,0x2a,0x4d,0x2a,0x4d,0x2a,0x4d,0x2a,0x4d,0x2a,0x4d,0x2a,0x4d,0x2a,0x4d,0x2a,0x4d,0x2a,0x4d,0x2a,0x4d,0x2a,0x4d,0x2a,0x4d,0x2a,0x4d,0x2a,0x4d,0x2a,0x4d,0x2a,0x4d,0x2a,0x4d,0x2a,0x4d,0x2a,0x4d,0x2a,0x4d,0x2a,0x4d,0x2a,0x4d,0x2a,0x4d,0x2a,0x4d,0x2a,0x4d,0x2a,0x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
		,0x42,0xef,0x2a,0x6d,0x2a,0x6d,0x2a,0x6d,0x2a,0x6d,0x2a,0x6d,0x2a,0x6d,0x2a,0x6d,0x2a,0x6d,0x2a,0x6d,0x2a,0x6d,0x2a,0x6d,0x2a,0x6d,0x2a,0x6d,0x2a,0x6d,0x2a,0x6d,0x2a,0x6d,0x2a,0x6d,0x2a,0x6d,0x2a,0x6d,0x2a,0x6d,0x2a,0x6d,0x2a,0x6d,0x2a,0x6d,0x2a,0x6d,0x2a,0x6d,0x2a,0x6d,0x2a,0x6d,0x2a,0x6d,0x2a,0x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
		,0x42,0xef,0x2a,0x6d,0x2a,0x6d,0x2a,0x6d,0x2a,0x6d,0x2a,0x6d,0x2a,0x6d,0x2a,0x6d,0x2a,0x6d,0x2a,0x6d,0x2a,0x6d,0x2a,0x6d,0x2a,0x6d,0x2a,0x6d,0x2a,0x6d,0x2a,0x6d,0x2a,0x6d,0x2a,0x6d,0x2a,0x6d,0x2a,0x6d,0x2a,0x6d,0x2a,0x6d,0x2a,0x6d,0x2a,0x6d,0x2a,0x6d,0x2a,0x6d,0x2a,0x6d,0x2a,0x6d,0x2a,0x6d,0x2a,0x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
		,0x42,0xef,0x2a,0x6d,0x2a,0x6d,0x2a,0x6d,0x2a,0x6d,0x2a,0x6d,0x2a,0x6d,0x2a,0x6d,0x2a,0x6d,0x2a,0x6d,0x2a,0x6d,0x2a,0x6d,0x2a,0x6d,0x2a,0x6d,0x2a,0x6d,0x2a,0x6d,0x2a,0x6d,0x2a,0x6d,0x2a,0x6d,0x2a,0x6d,0x2a,0x6d,0x2a,0x6d,0x2a,0x6d,0x2a,0x6d,0x2a,0x6d,0x2a,0x6d,0x2a,0x6d,0x2a,0x6d,0x2a,0x6d,0x2a,0x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
		,0x42,0xef,0x2a,0x6d,0x2a,0x6d,0x2a,0x6d,0x2a,0x6d,0x2a,0x6d,0x2a,0x6d,0x2a,0x6d,0x2a,0x6d,0x2a,0x6d,0x2a,0x6d,0x2a,0x6d,0x2a,0x6d,0x2a,0x6d,0x2a,0x6d,0x2a,0x6d,0x2a,0x6d,0x2a,0x6d,0x2a,0x6d,0x2a,0x6d,0x2a,0x6d,0x2a,0x6d,0x2a,0x6d,0x2a,0x6d,0x2a,0x6d,0x2a,0x6d,0x2a,0x6d,0x2a,0x6d,0x2a,0x6d,0x2a,0x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
		,0x42,0xef,0x2a,0x6d,0x2a,0x6d,0x2a,0x6d,0x2a,0x6d,0x2a,0x6d,0x2a,0x6d,0x2a,0x6d,0x2a,0x6d,0x2a,0x6d,0x2a,0x6d,0x2a,0x6d,0x2a,0x6d,0x2a,0x6d,0x2a,0x6d,0x2a,0x6d,0x2a,0x6d,0x2a,0x6d,0x2a,0x6d,0x2a,0x6d,0x2a,0x6d,0x2a,0x6d,0x2a,0x6d,0x2a,0x6d,0x2a,0x6d,0x2a,0x6d,0x2a,0x6d,0x2a,0x6d,0x2a,0x6d,0x2a,0x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
		,0x42,0xef,0x2a,0x6d,0x2a,0x6d,0x2a,0x6d,0x2a,0x6d,0x2a,0x6d,0x2a,0x6d,0x2a,0x6d,0x2a,0x6d,0x2a,0x6d,0x2a,0x6d,0x2a,0x6d,0x2a,0x6d,0x2a,0x6d,0x2a,0x6d,0x2a,0x6d,0x2a,0x6d,0x2a,0x6d,0x2a,0x6d,0x2a,0x6d,0x2a,0x6d,0x2a,0x6d,0x2a,0x6d,0x2a,0x6d,0x2a,0x6d,0x2a,0x6d,0x2a,0x6d,0x2a,0x6d,0x2a,0x6d,0x2a,0x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
		,0x42,0xef,0x2a,0x6d,0x2a,0x6d,0x2a,0x6d,0x2a,0x6d,0x2a,0x6d,0x2a,0x6d,0x2a,0x6d,0x2a,0x6d,0x2a,0x6d,0x2a,0x6d,0x2a,0x6d,0x2a,0x6d,0x2a,0x6d,0x2a,0x6d,0x32,0x6d,0x32,0x6d,0x32,0x6c,0x32,0x6c,0x32,0x6c,0x32,0x6c,0x32,0x6c,0x32,0x6c,0x32,0x6c,0x32,0x6c,0x32,0x6c,0x32,0x6c,0x32,0x6c,0x32,0x6c,0x32,0x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
		,0x42,0xef,0x2a,0x6d,0x2a,0x6d,0x2a,0x6d,0x2a,0x6d,0x2a,0x6d,0x2a,0x6d,0x2a,0x6d,0x2a,0x6d,0x2a,0x6d,0x2a,0x6d,0x2a,0x6d,0x2a,0x6d,0x2a,0x6d,0x2a,0x6d,0x32,0x6c,0x42,0x4a,0x5a,0xec,0x5b,0x0c,0x5b,0x0c,0x5b,0x0c,0x5b,0x0c,0x5b,0x0c,0x5b,0x0c,0x5b,0x0c,0x5b,0x0c,0x5b,0x0c,0x5b,0x0c,0x5b,0x0c,0x5b,0x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
		,0x42,0xef,0x2a,0x6d,0x2a,0x6d,0x2a,0x6d,0x2a,0x6d,0x2a,0x6d,0x2a,0x6d,0x2a,0x6d,0x2a,0x6d,0x2a,0x6d,0x2a,0x6d,0x2a,0x6d,0x2a,0x6d,0x2a,0x6d,0x2a,0x6d,0x32,0x6c,0x5a,0xec,0xbd,0xd7,0xd6,0xba,0xd6,0xba,0xd6,0xba,0xd6,0xba,0xd6,0xba,0xd6,0xba,0xd6,0xba,0xd6,0xba,0xd6,0xba,0xd6,0xba,0xd6,0xba,0xd6,0x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
		,0x42,0xef,0x2a,0x6d,0x2a,0x6d,0x2a,0x6d,0x2a,0x6d,0x2a,0x6d,0x2a,0x6d,0x2a,0x6d,0x2a,0x6d,0x2a,0x6d,0x2a,0x6d,0x2a,0x6d,0x2a,0x6d,0x2a,0x6d,0x2a,0x6d,0x32,0x4c,0x63,0x2d,0xde,0xfb,0xff,0xff,0xff,0xff,0xff,0xff,0xff,0xff,0xff,0xff,0xff,0xff,0xff,0xff,0xff,0xff,0xff,0xff,0xff,0xff,0xff,0xff,0xff,0x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
		,0x42,0xef,0x2a,0x6d,0x2a,0x6d,0x2a,0x6d,0x2a,0x6d,0x2a,0x6d,0x2a,0x6d,0x2a,0x6d,0x2a,0x6d,0x2a,0x6d,0x2a,0x6d,0x2a,0x6d,0x2a,0x6d,0x2a,0x6d,0x2a,0x6d,0x32,0x4c,0x63,0x2d,0xde,0xfb,0xff,0xff,0xff,0xff,0xff,0xff,0xff,0xff,0xff,0xff,0xff,0xff,0xff,0xff,0xff,0xff,0xff,0xff,0xff,0xff,0xff,0xff,0xff,0x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
		,0x42,0xef,0x2a,0x6d,0x2a,0x6d,0x2a,0x6d,0x2a,0x6d,0x2a,0x6d,0x2a,0x6d,0x2a,0x6d,0x2a,0x6d,0x2a,0x6d,0x2a,0x6d,0x2a,0x6d,0x2a,0x6d,0x2a,0x6d,0x2a,0x6d,0x32,0x4c,0x63,0x2d,0xde,0xfb,0xff,0xff,0xff,0xff,0xff,0xff,0xff,0xff,0xff,0xff,0xff,0xff,0xff,0xff,0xff,0xff,0xff,0xff,0xff,0xff,0xff,0xff,0xff,0x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
		,0x42,0xef,0x2a,0x6d,0x2a,0x6d,0x2a,0x6d,0x2a,0x6d,0x2a,0x6d,0x2a,0x6d,0x2a,0x6d,0x2a,0x6d,0x2a,0x6d,0x2a,0x6d,0x2a,0x6d,0x2a,0x6d,0x2a,0x6d,0x2a,0x6d,0x32,0x4c,0x63,0x2d,0xde,0xfb,0xff,0xff,0xff,0xff,0xff,0xff,0xff,0xff,0xff,0xff,0xff,0xff,0xff,0xff,0xff,0xff,0xff,0xff,0xff,0xff,0xff,0xff,0xff,0x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
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
