MarioGavran/smart_intercom/Core/Src/ietk_logo_image.c

/*
 * ietk_logo_image.c
 *
 *  Created on: Oct 2, 2021
 *      Author: enio
 */
#include <ietk_logo_image.h>

const unsigned char g_ietk_logo_image[IETK_LOGO_IMG_SIZE] = {

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

};
