MarioGavran/smart_intercom/Core/Inc/feri_logo_image.h

#ifndef FERI_LOGO_IMAGE_H_
#define FERI_LOGO_IMAGE_H_

#define FERI_LOGO_IMG_H		111
#define FERI_LOGO_IMG_W		320
#define FERI_LOGO_IMG_SIZE	FERI_LOGO_IMG_H * FERI_LOGO_IMG_W * 2

extern const unsigned char g_feri_logo_image[FERI_LOGO_IMG_SIZE];

#endif
