MarioGavran/smart_intercom/Core/Inc/ietk_logo_image.h

/*
 * ietk_logo_image.h
 *
 *  Created on: Oct 2, 2021
 *      Author: enio
 */

#ifndef INC_IETK_LOGO_IMAGE_H_
#define INC_IETK_LOGO_IMAGE_H_

#define IETK_LOGO_IMG_H		90
#define IETK_LOGO_IMG_W		180
#define IETK_LOGO_IMG_SIZE	IETK_LOGO_IMG_W * IETK_LOGO_IMG_H * 2

extern const unsigned char g_ietk_logo_image[IETK_LOGO_IMG_SIZE];

#endif /* INC_IETK_LOGO_IMAGE_H_ */
