MarioGavran/smart_intercom/(commit log)

2021-06-13 this is a stm32cubeide_linux_test repo with added tflite micro engine
2022-01-03 fix camera colors, fix I2C, add touchscreen
    [OV7670.c, OV7670.h, app_main.c, app_main.h, fsmc_driver.h]
2022-01-08 touchscreen driver with interrupt trigger and state machine
2022-01-08 touchscreen driver update
2022-01-10 touchscreen interrupt fix
2022-01-14 touchscreen update, problem solvd by clearing EXTI->PR in the select_adc fnc, at the end of the touch_process
    [touch_driver.c]
2022-01-15 touchscreen update, fix RELEASED condition
    [app_main.c, touch_driver.c, touch_driver.h]
2022-01-24 update touch_driver, add IIR filter and fix RELEASE condition
    [touch_driver.c, touch_driver.h]
2022-01-26 update touch_driver, fix touch precision
    [app_main.c, touch_driver.c]
2022-07-08 update full screen
    [smart_intercom2 Release.cfg]
