MarioGavran/smart_intercom/images/20210518_152727.jpg

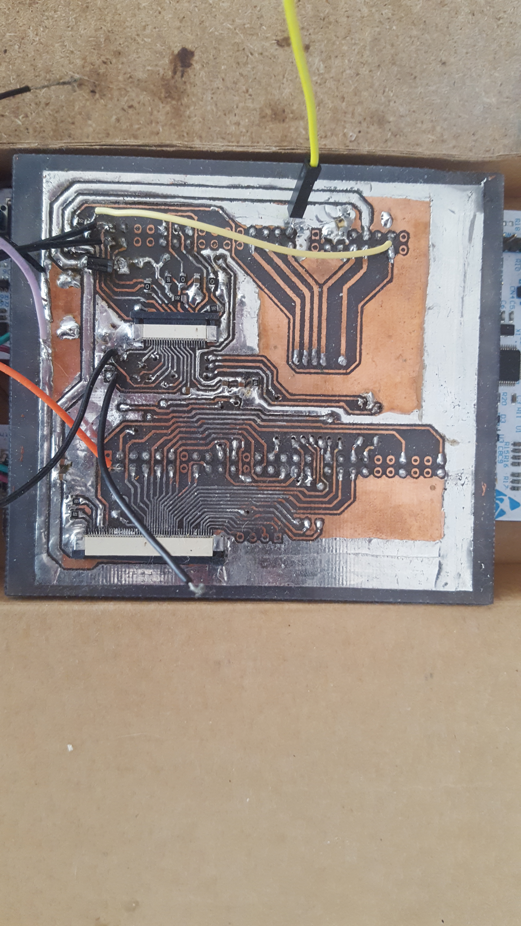
images/20210518_152727.jpg
