MarioGavran/smart_intercom/images/20210518_152849.jpg

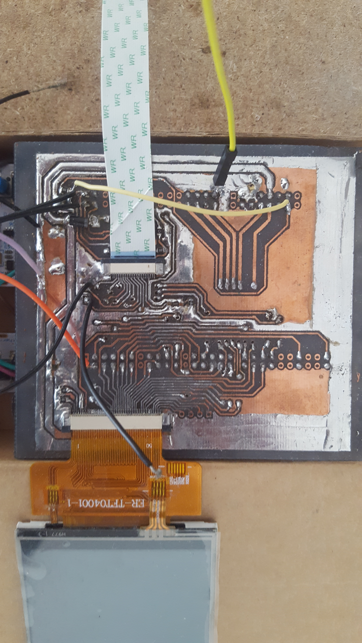
images/20210518_152849.jpg
